uiqvb/SIT315-M1T1/images/serial_monitor.png

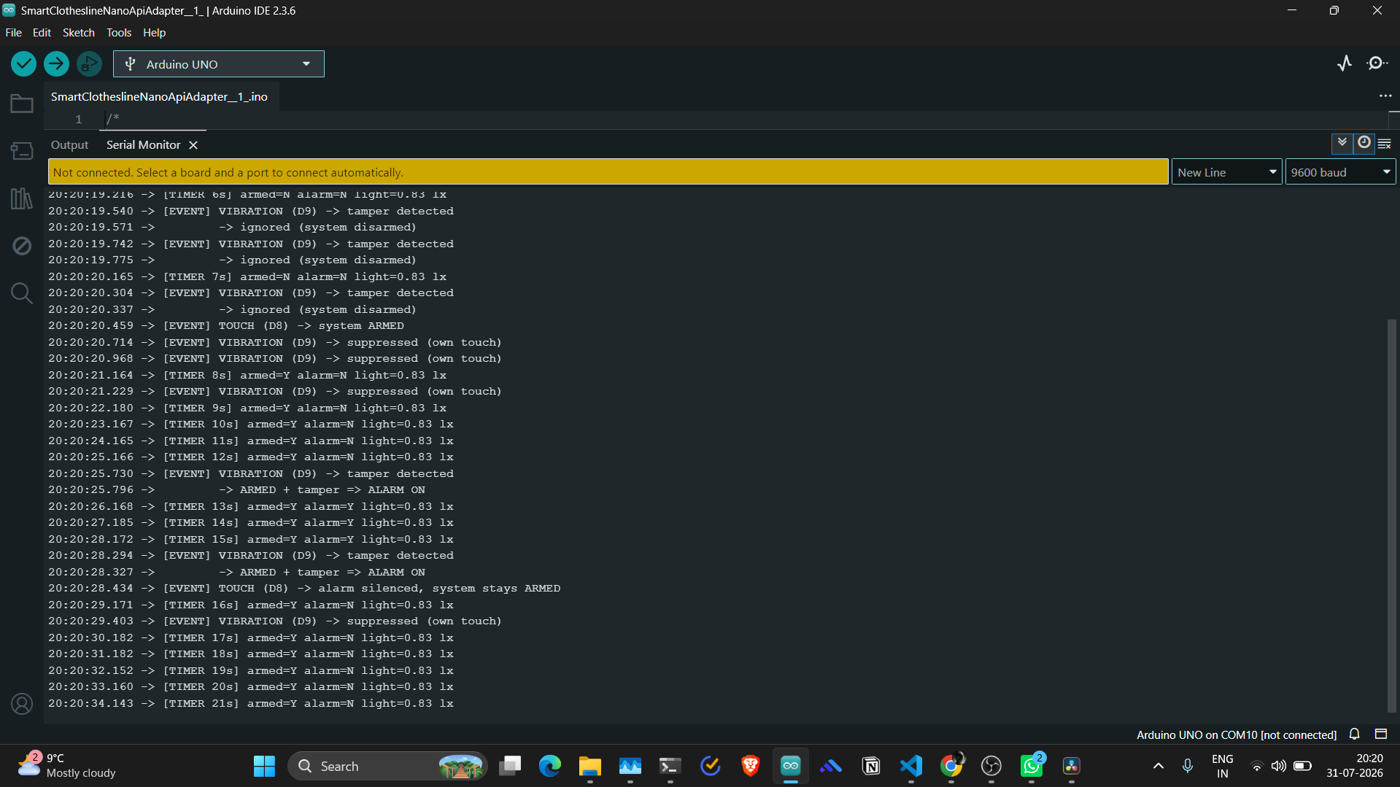
images/serial_monitor.png
