uiqvb/SIT315-M1T1/(commit log)

2026-07-31 Interrupt-driven intrusion and tamper alarm for Arduino Uno
    Sense-Think-Act security system using three interrupt types running
    concurrently: INT0 external interrupt on D2 for IR intrusion detection,
    a shared PCINT0 vector covering the D8 touch pad and D9 vibration switch,
    and a Timer1 CTC interrupt driving a 1 Hz periodic task.
    All interrupt handlers only raise volatile flags; decisions, I2C reads
    and serial output are deferred to loop().
2026-07-31 Add circuit diagram and Serial Monitor screenshot to README
2026-10-10 Add two board version: Nano 33 IoT LDR node feeding the Uno over PCINT2
    Moves the first submission into single_board/ unchanged and adds the Uno and Nano sketches for the two board system under two_board/.
2026-10-10 Add two board demo video link
2026-10-10 Add wiring diagram and Serial Monitor screenshots for the two board system
2026-10-10 Add first submission PDF and single board demo video link
